TriWrite/VESC-Ninebot-Max-G2/(threads)

Thread 1 (2025-05-17):

Please I need very fast help for that code

IZorixI, 2025-05-17:
Hi,
I found your code here and im so thankful that this exist. So I ordered an Arduino Nano Esp32 and the other parts. I wired everything correctly and the dash is also turning on for one sec when i connect it to the power like always. But if I press the button i wont turn on. And the vesc console says No I2C comm.

Can someone help me please? 🙏🙏

Thank you
