TriWrite/VESC-Ninebot-Max-G2/(commit log)

2024-10-01 Create VESC Arduino ESP32.lisp
    lispBM script for VESC v6.0.5+ to handle communication between VESC and Arduino Nano ESP32 via I2C.
2024-10-01 Create Ninebot Max G2 Nano ESP32.ino
    Arduino sketch (for Arduino Nano ESP32) to support single-wire UART communication with Ninebot Max G2 BLE/dash and I2C communication with VESC
2024-10-01 Picture of wiring on prototype board
    I only got a soldering iron like a month ago, so...
2024-10-03 Update Ninebot Max G2 ESP32.ino
    Fix handling of off-lock-on status loop
    [Ninebot Max G2 ESP32.ino]
2024-10-04 Update Ninebot Max G2 ESP32.ino
    Be a bit more sparing with watchdog timer resets. Be more thoughtful about entering critical sections. Do not send out-of-date throttle or brake inputs to VESC to prevent controls stuck "on" in case of UART Rx failure.
    [Ninebot Max G2 ESP32.ino]
2024-10-06 Update Ninebot Max G2 ESP32.ino
    Improve handling of globals:
    -for I2C receive, use function scoped temporary variable to perform manipulations on speed received from VESC instead of changing global value multiple times
    -for I2C send, retrieve time of last dash inputs received within critical section
    Don't force unnecessary type conversion from int64_t to uint64_t for ESP timer return value
2024-10-07 Update Ninebot Max G2 ESP32.ino
    Sometimes UART updates get out sync, leading to stuttering inputs. As a safety measure, if we detect that UART comms are lagging, then restart the UART task.
    Move 0x64 packet handling within conditional for valid packet.
    Adjust stack sizes for tasks
2024-10-07 Update VESC Arduino ESP32.lisp
2024-10-08 Update VESC Arduino ESP32.lisp
    Adding in rudimentary speed mode support.
    Limits on current and max speed for Drive (0.7x current scale, 22mph) and Eco (0.5x current scale, 15mph)
